ArkX-Lab/TPS65217_Test/HW/Rev_A/JLCPCB/BOM_250725.xlsx

Comment | Description | Designator | Quantity | LCSC Part #
22uF/25V/2012 | Ceramic CAP_22uF/25V/2012 | C300 | 1 | C45783
100nF/50V/1608/NC | Ceramic CAP_100nF/50V/1608 | C301 | 1
100nF/50V/1608 | Ceramic CAP_100nF/50V/1608 | C302, C303, C306, C310, C311, C315, C400, C401, C405, C500 | 10 | C14663
10uF/25V/1608 | Ceramic CAP_10uF/25V/1608 | C304, C313, C316, C317, C318, C319, C320, C321, C322, C323, C324, C325, C328, C329 | 14 | C96446
2.2uF/16V/1608 | Ceramic CAP_2.2uF/16V/1608 | C305, C309, C326, C327 | 4 | C23630
470pF/50V/1608 | Ceramic CAP_470pF/50V/1608 | C307 | 1 | C1620
10uF/10V/1608 | Ceramic CAP_10uF/10V/1608 | C308, C312 | 2 | C19702
1uF/50V/1608 | Ceramic CAP_1uF/50V/1608 | C314 | 1 | C15849
4.7uF/16V/1608 | Ceramic CAP_4.7uF/16V/1608 | C402 | 1 | C19666
100nF/16V/1005 | Ceramic CAP_100nF/16V/1005 | C403 | 1 | C1525
15pF/16V/1608/NC | Ceramic CAP_15pF/16V/1608 | C404 | 1
0R/3216 | RES_0R/3216/0.25W | R300, R301 | 2 | C17888
10K/1608/NC | RES_10K/1608/0.1W | R302, R303 | 2
100K/1608 | RES_100K/1608/0.1W | R304, R305, R323, R400, R401 | 5 | C25803
680R/2012 | RES_680R/2012/0.125W | R306, R500 | 2 | C17798
0R/2012 | RES_0R/2012/0.125W | R307, R308, R309, R310, R311, R313, R315 | 7 | C17477
200K/1608 | RES_200K/1608/0.1W | R312 | 1 | C25811
510R/1608 | RES_510R/1608/0.1W | R314, R328, R329, R402, R403, R404, R405 | 7 | C23193
330K/1608 | RES_330K/1608/0.1W | R316 | 1 | C23137
1.5K/2012 | RES_1.5K/2012/0.125W | R317, R318 | 2 | C4310
0R/1608 | RES_0R/1608/0.1W | R319, R320, R321, R322, R324, R325, R326, R327 | 8 | C21189
1M/1608 | RES_1M/1608/0.1W | R501 | 1 | C22935
TPS65217DRSLR | Battery Management, Display (LED Drivers), Handheld/Mobile Devices, Power Supply PMIC 48-VQFN (6x6) | U300 | 1 | C702315
MIC5209YM-TR | Linear Voltage Regulator IC Positive Adjustable 1 Output 500mA 8-SOIC | U301 | 1 | C461593
AMS1117-3.3 | 72dB@(120Hz) 1A 1.3V@(800mA) Fixed 3.3V~3.3V Positive 1 SOT-223 Linear Voltage Regulators (LDO) ROHS | U302 | 1 | C6186
STM32C011F6U6TR | ARM® Cortex®-M0+ STM32C0 Microcontroller IC 32-Bit 48MHz 32KB (32K x 8) FLASH 20-UFQFPN (3x3) | U400 | 1 | C5456206
SX1M48.000M10F30TNN(48MHz) | 1.62V~3.63V ±10ppm CMOS 48MHz SMD2016-4P Oscillators ROHS | X400 | 1 | C2901617
LQM2HPN2R2MG0L | 2.2 µH Shielded Multilayer Inductor 1.3 A 100mOhm Max 1008 (2520 Metric) | L300, L301, L302 | 3 | C86092
GREEN/2012 | Colorless transparence -30℃~+85℃ Positive post Common anode RGB 120° 0805 Light Emitting Diodes (LED) ROHS | LED300, LED301, LED302, LED303, LED500 | 5 | C2962094
BLUE/2012 | Colorless transparence -30℃~+85℃ Positive post Common anode RGB 120° 0805 Light Emitting Diodes (LED) ROHS | LED400, LED401, LED402, LED403 | 4 | C2962094
MC-311S | USB 2.0 5A 1 Surface Mount 16 Female -35℃~+75℃ Type-C SMD USB Connectors ROHS | CN501 | 1 | C2977718
K2-1102SP-C4SC-04 | -25℃~+85℃ 6mm 5mm Round Button 50mA Brick nogging 6mm SPST 100MΩ 100000 250gf@±30gf 12V SMD Tactile Switches ROHS | SW300, SW301, SW401 | 3 | C127509
