ArkX-Lab/TPS65217_Test/HW/Rev_A/TPS65217_Test_Bd/TPS65217_Test_Bd.pdf

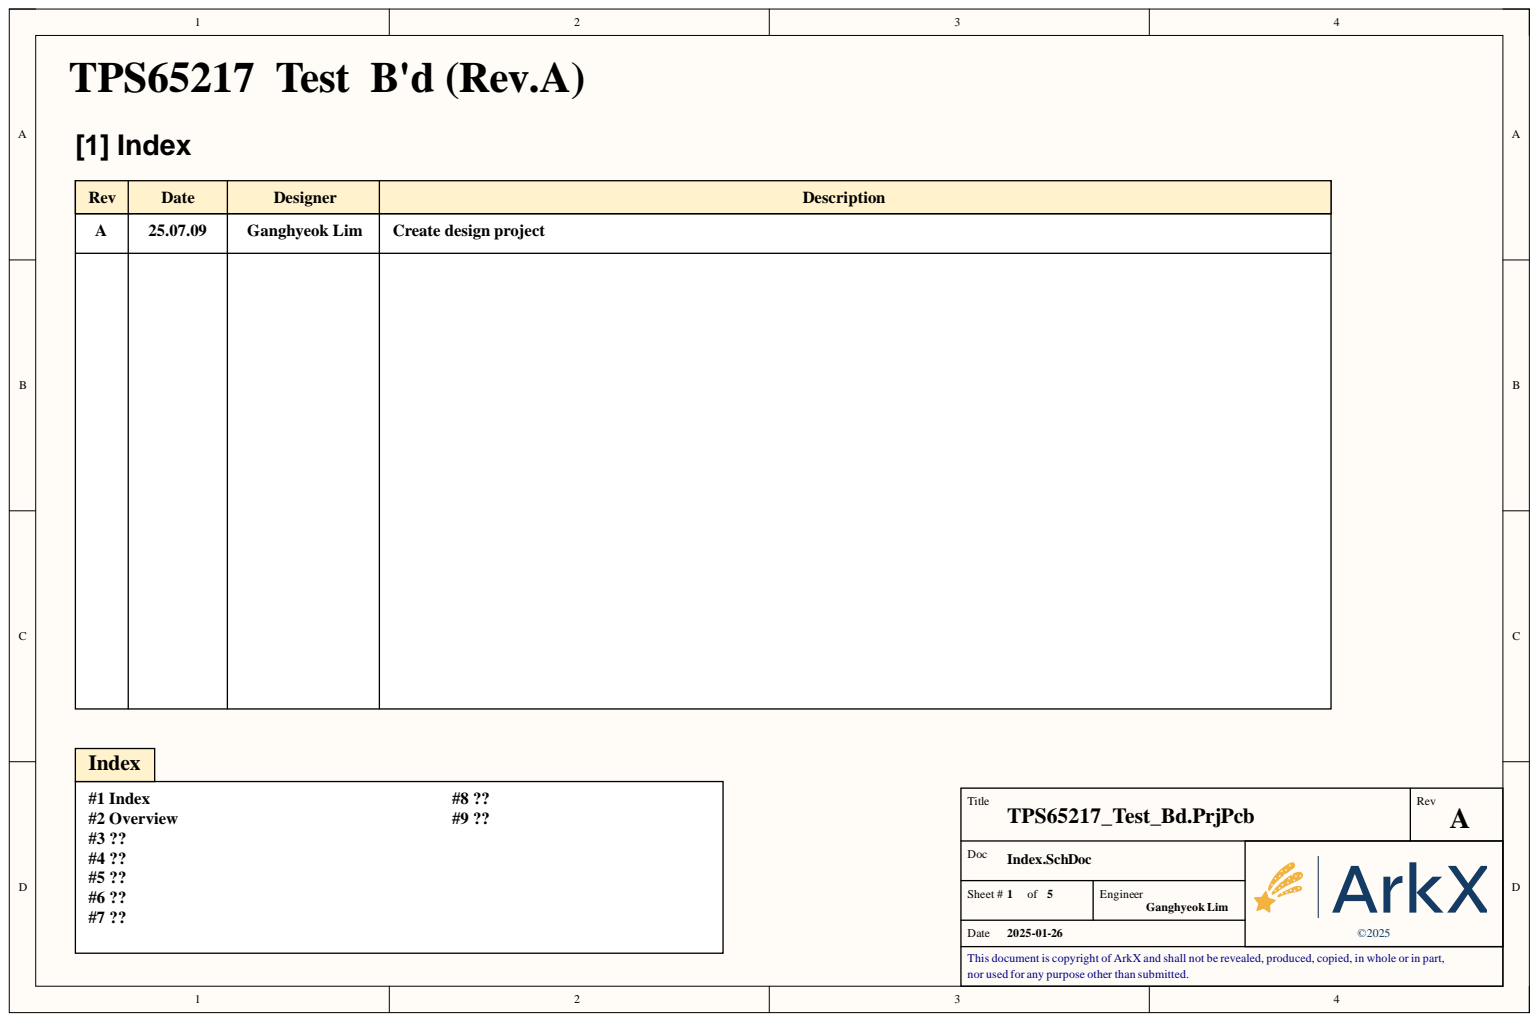
[picture p1: page 1]

Rev | Date | Designer | Description

A | 25.07.09 | Ganghyeok Lim | Create design project

Title TPS65217_Test_Bd.PrjPcb | Rev A

Doc Index.SchDoc | ©2025

Sheet # 1 of 5 | Engineer Ganghyeok Lim

This document is copyright of ArkX and shall not be revealed, produced, copied, in whole or in part,
nor used for any purpose other than submitted.

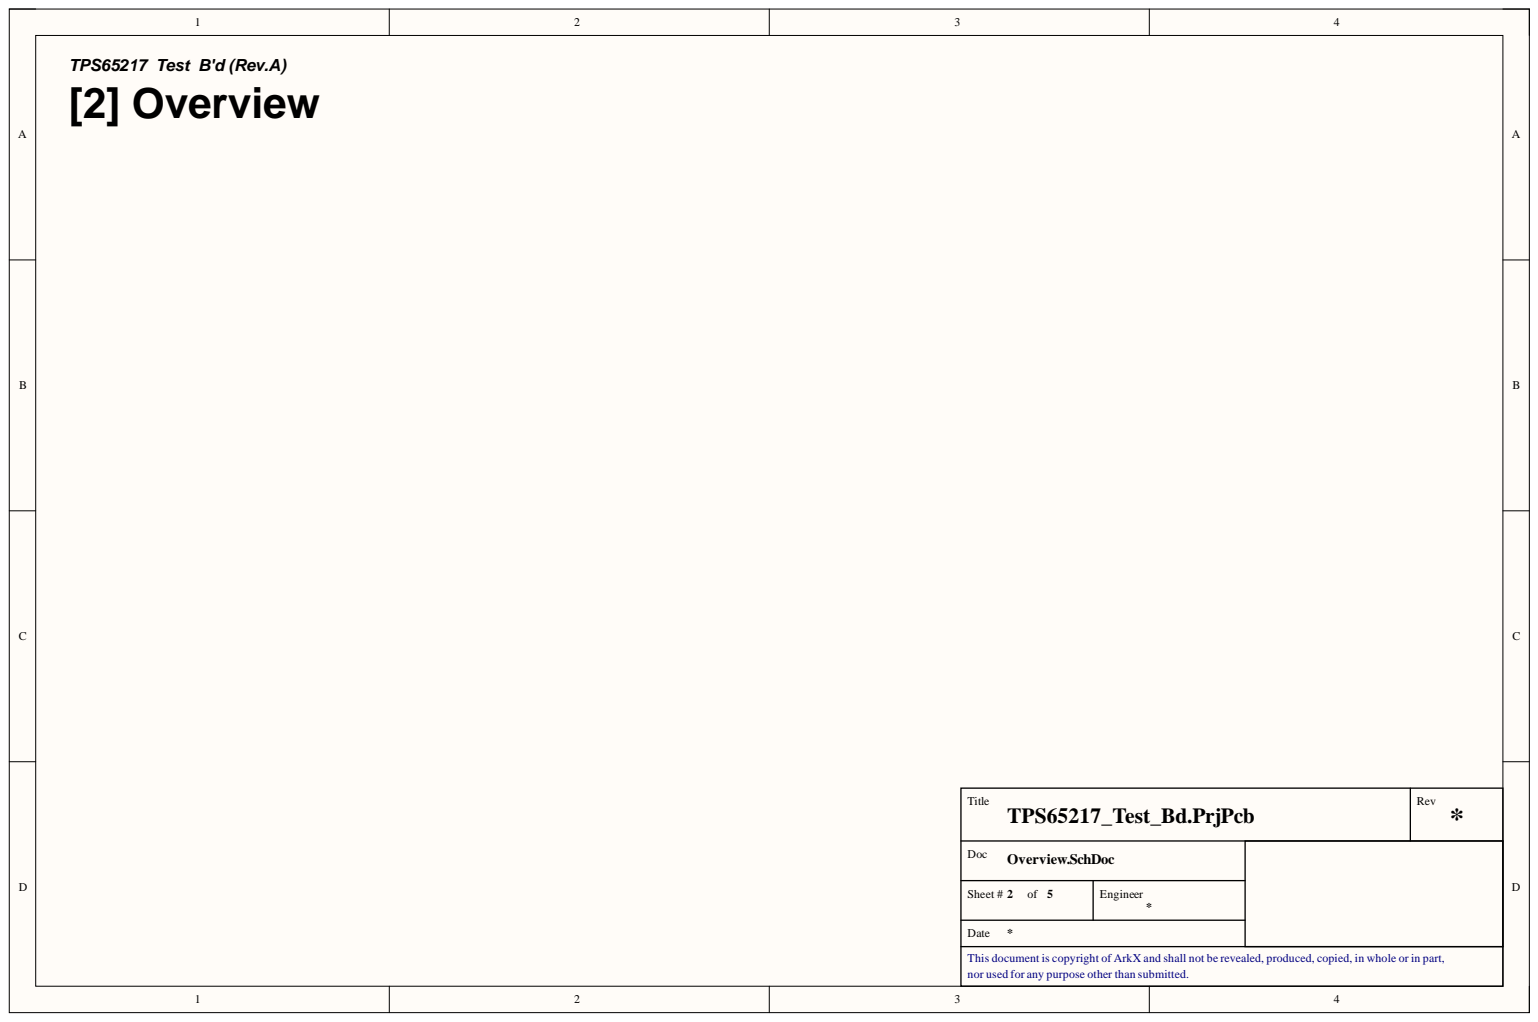
[picture p2: page 2]

Title TPS65217_Test_Bd.PrjPcb | Rev *

Doc Overview.SchDoc

Sheet # 2 of 5 | Engineer *

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

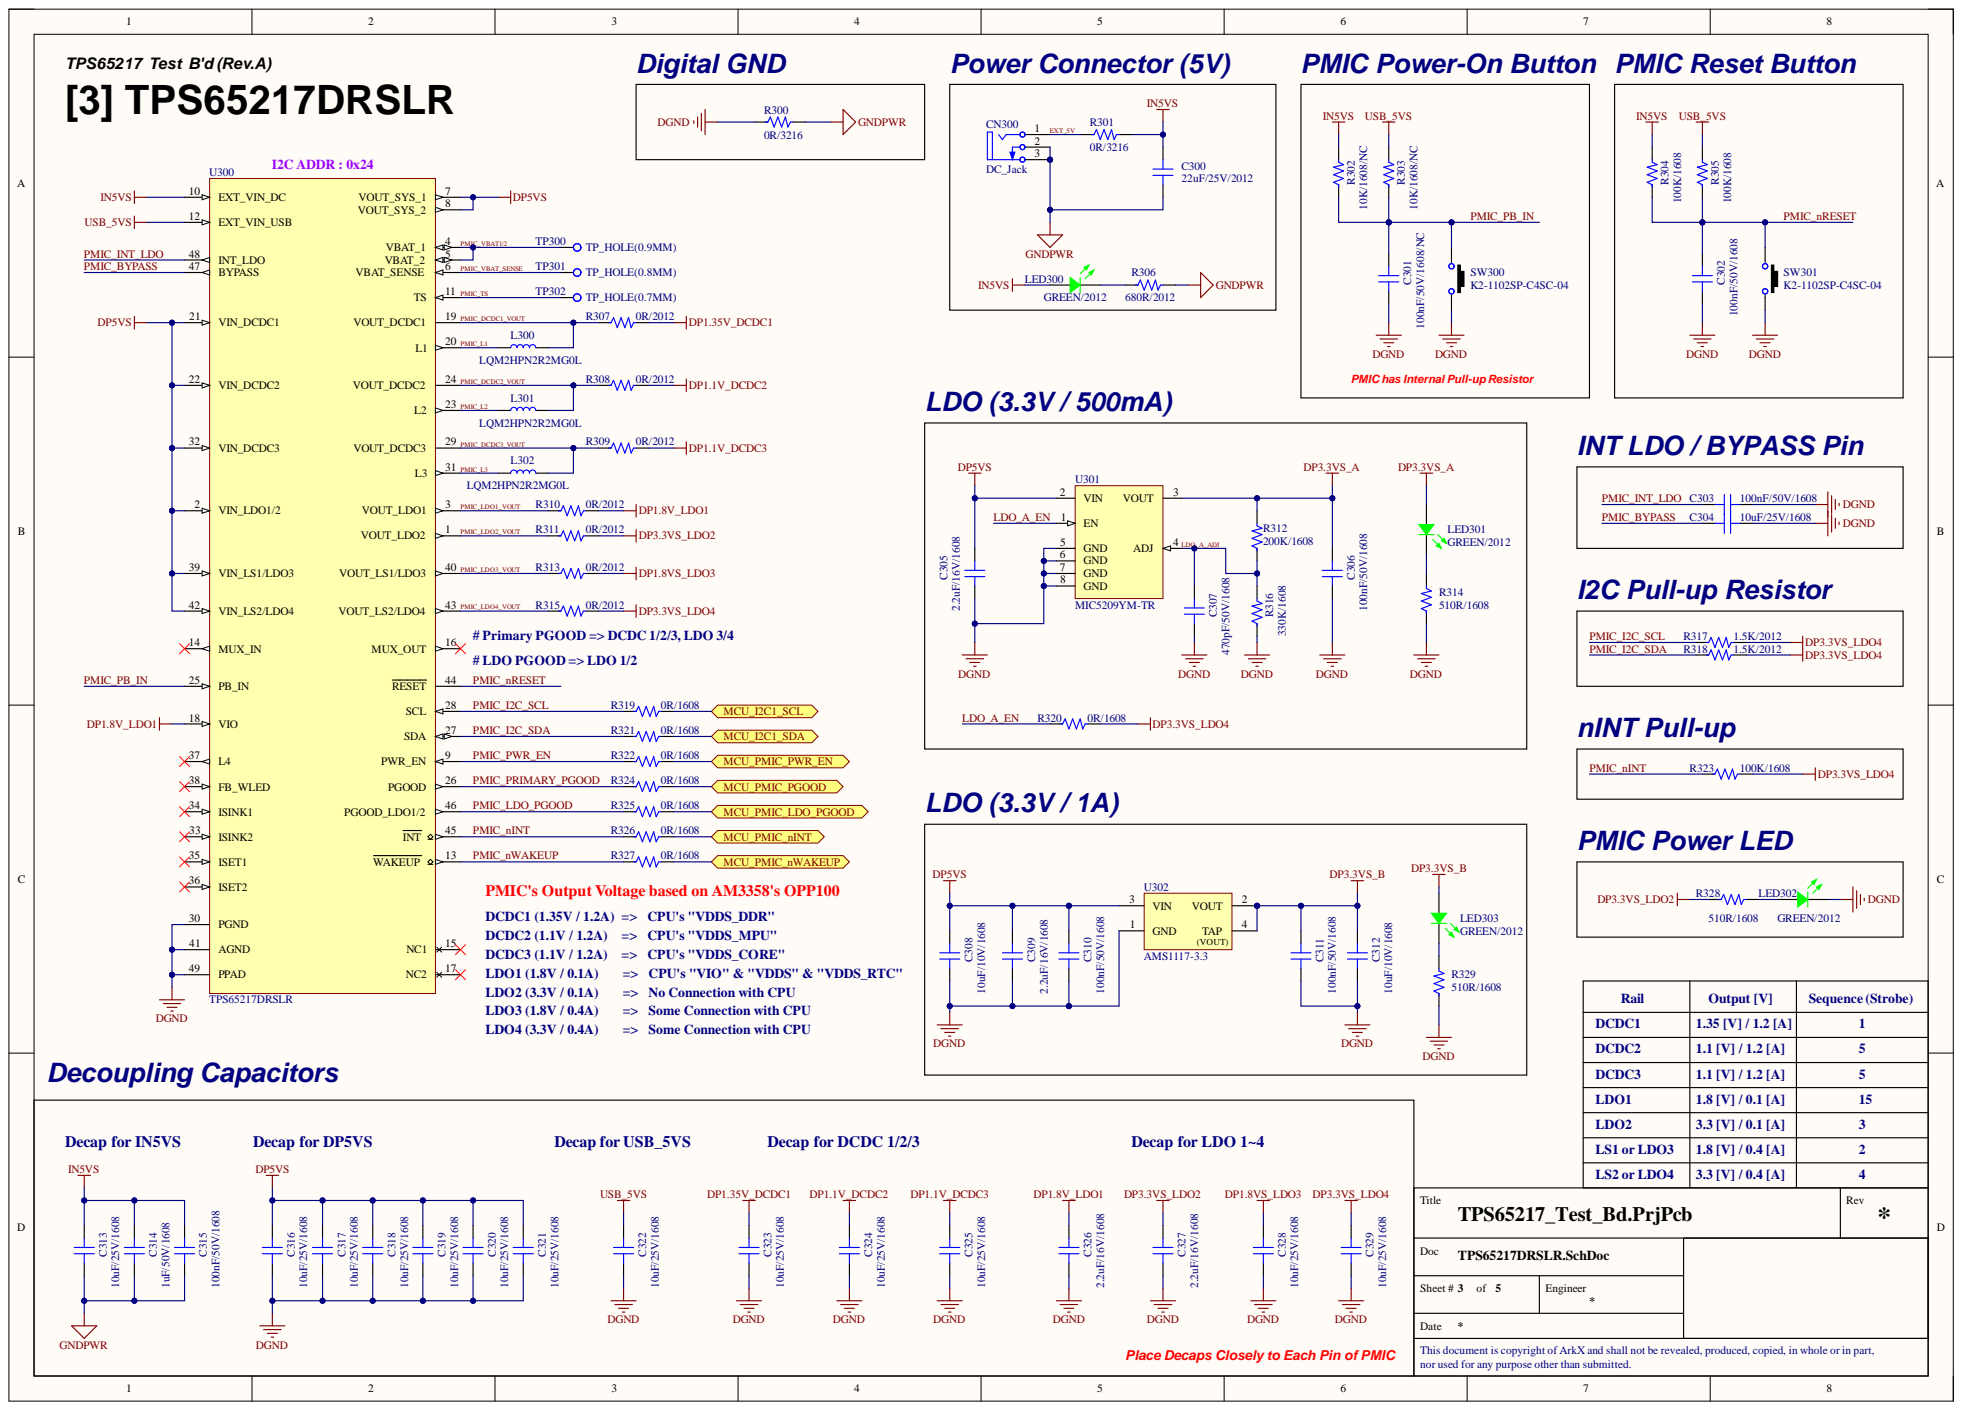
[picture p3: page 3]

PMIC Power-On Button

VIN_DCDC2 22

PMIC has Internal Pull-up Resistor

VIN_DCDC3 32

INT LDO / BYPASS Pin

# Primary PGOOD => DCDC 1/2/3, LDO 3/4

GND 1

AGND 41

PPAD 49

Rail | Output [V] | Sequence (Strobe)

DCDC1 | 1.35 [V] / 1.2 [A] | 1

DCDC3 | 1.1 [V] / 1.2 [A] | 5

LDO1 | 1.8 [V] / 0.1 [A] | 15

LDO2 | 3.3 [V] / 0.1 [A] | 3

LS1 or LDO3 | 1.8 [V] / 0.4 [A] | 2

LS2 or LDO4 | 3.3 [V] / 0.4 [A] | 4

Title TPS65217_Test_Bd.PrjPcb | Rev *

Doc TPS65217DRSLR.SchDoc

Sheet # 3 of 5 | Engineer *

Place Decaps Closely to Each Pin of PMIC

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

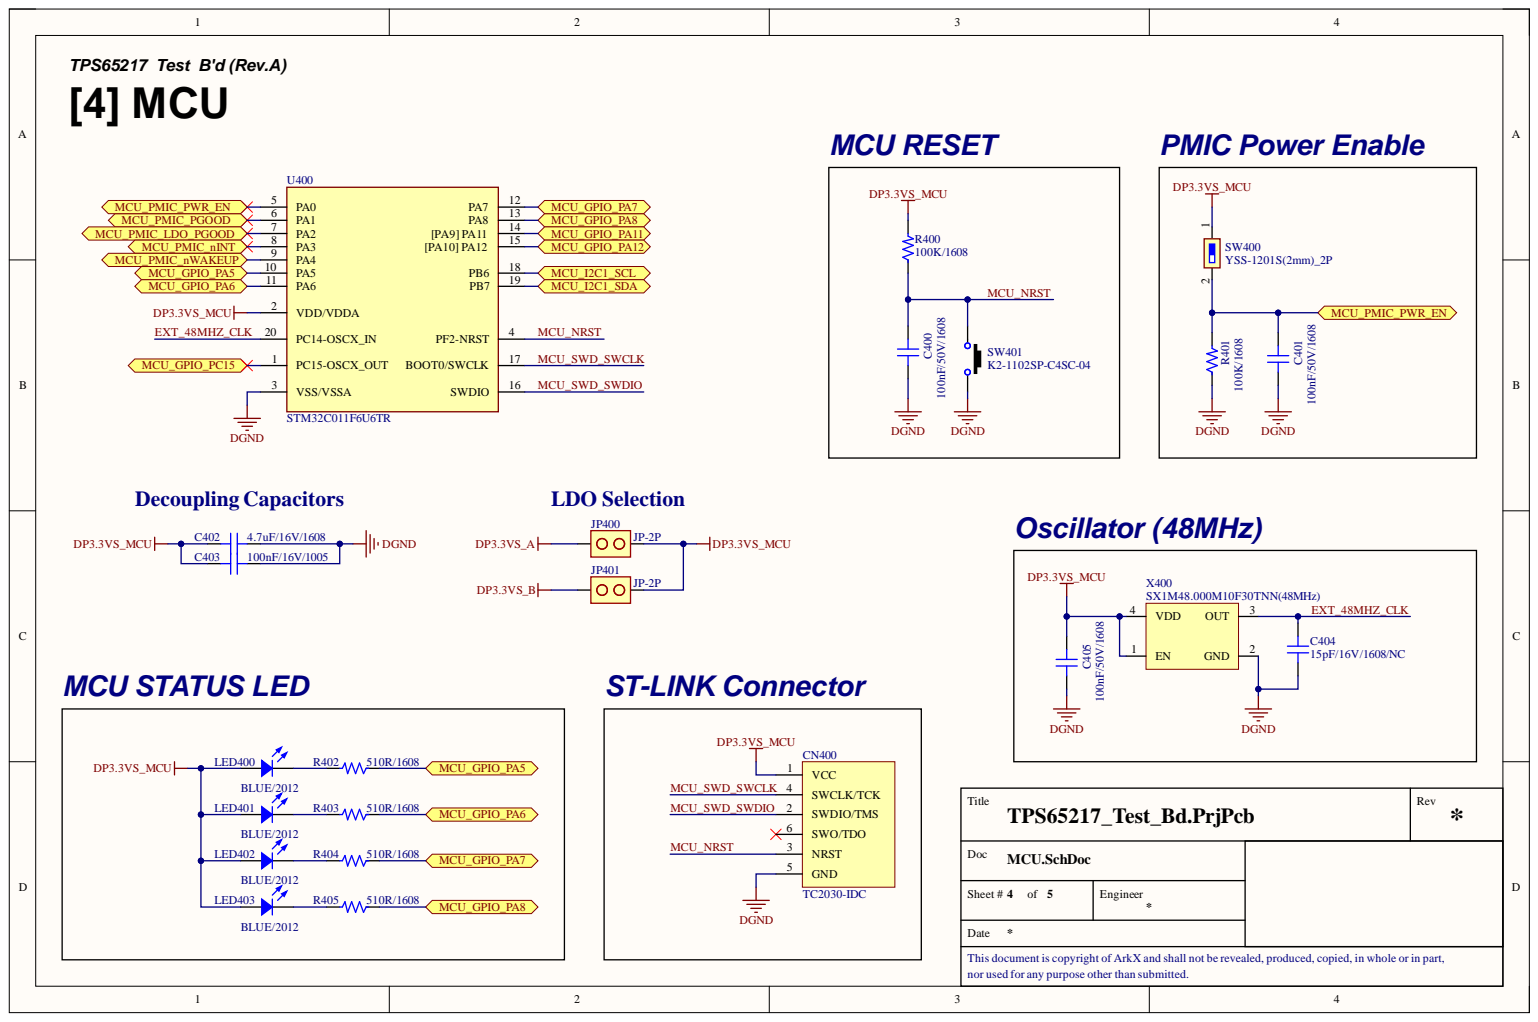
[picture p4: page 4]

Title TPS65217_Test_Bd.PrjPcb | Rev *

Doc MCU.SchDoc

Sheet # 4 of 5 | Engineer *

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

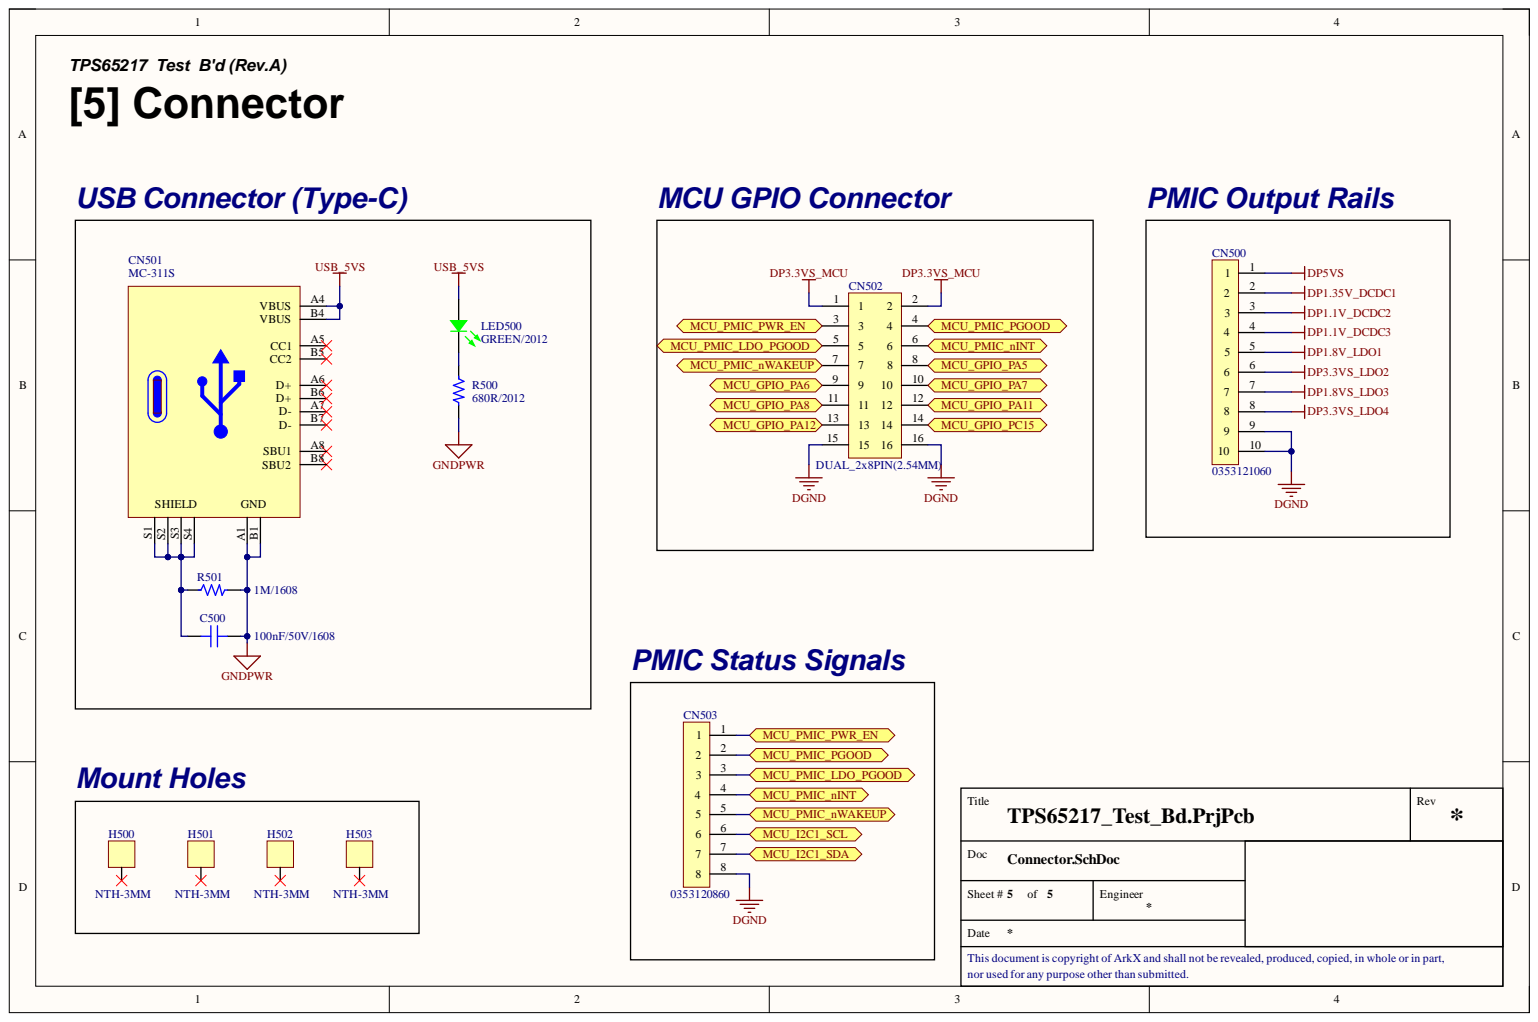
[picture p5: page 5]

Title TPS65217_Test_Bd.PrjPcb | Rev *

Doc Connector.SchDoc

Sheet # 5 of 5 | Engineer *

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

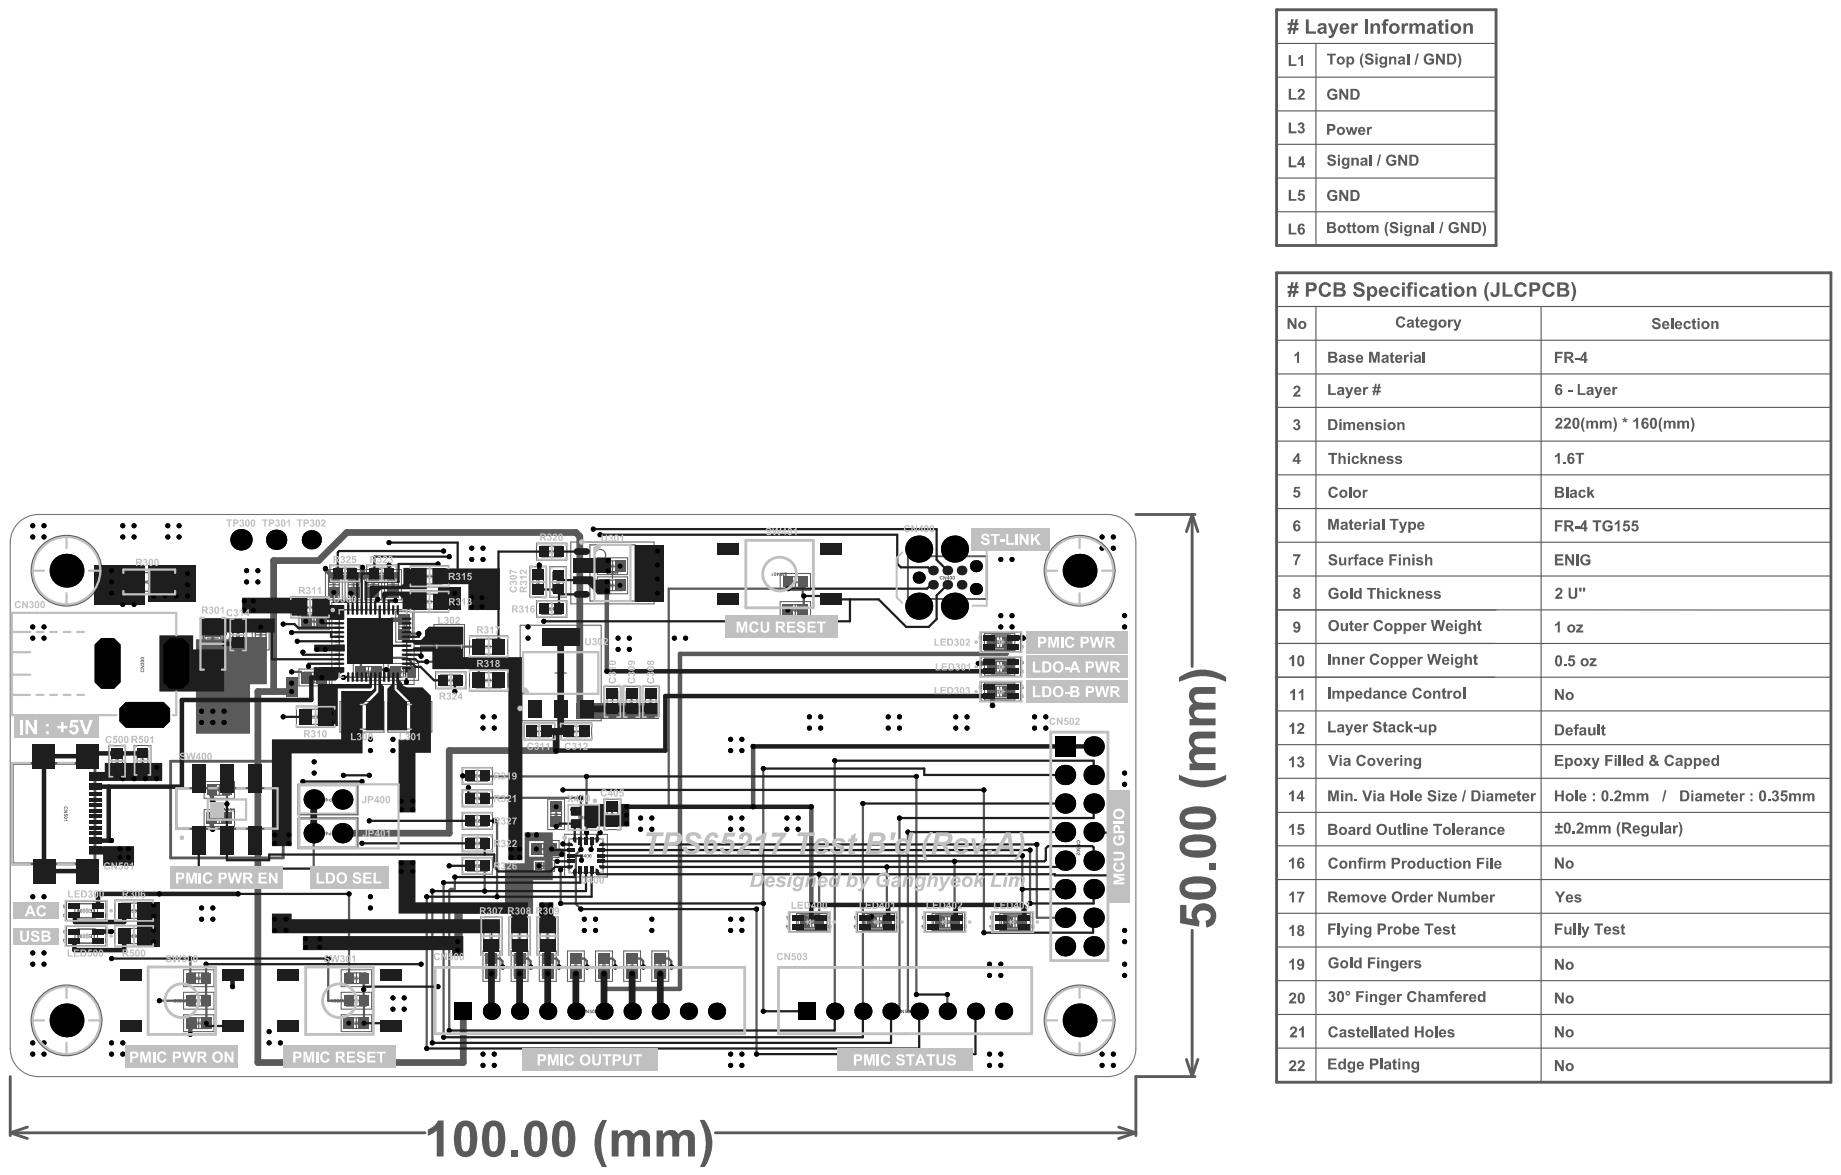
[picture p6: page 6]
