ArkX-Lab/TPS65217_Test/(list of files, drawings)

Other design files:
HW/Rev_A/TPS65217_Test_Bd/Connector.SchDoc
HW/Rev_A/TPS65217_Test_Bd/Index.SchDoc
HW/Rev_A/TPS65217_Test_Bd/MCU.SchDoc
HW/Rev_A/TPS65217_Test_Bd/Overview.SchDoc
HW/Rev_A/TPS65217_Test_Bd/TPS65217_Test_Bd.PrjPcb
HW/Rev_A/TPS65217_Test_Bd/TPS65217DRSLR.SchDoc
