ArkX-Lab/TPS65217_Test/FW/STM32_Project/CubeMX/Core/Src/main.c

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
/* Includes ------------------------------------------------------------------*/
#include "main.h"

/* USER CODE BEGIN PD */
#define MCU_GPIO_PA_X_Pin		MCU_GPIO_PA5_Pin
#define I2C1_SLAVE_ADDR 		(0x24 << 1)
#define REG_ADDR_CHIP_ID		(0x00)
#define REG_ADDR_INT			(0x02)
#define REG_ADDR_PASSWD			(0x0B)
#define REG_ADDR_ENABLE			(0x16)
#define REG_ADDR_SEQ6			(0x1E)
/* USER CODE END PD */


I2C_HandleTypeDef hi2c1;

/* USER CODE BEGIN PV */
uint8_t tx_buffer = 0;
uint8_t rx_buffer = 0;
uint8_t	chip_id = 0;
uint8_t int_status = 0;
uint8_t reg_enable = 0;
uint8_t reg_seq6 = 0;

uint8_t reg_passwd = 0;
/* USER CODE END PV */

void SystemClock_Config(void);
static void MX_GPIO_Init(void);
static void MX_I2C1_Init(void);
/**
  * @brief  The application entry point.
  * @retval int
  */
int main(void)
{

  /* MCU Configuration--------------------------------------------------------*/

  /* Reset of all peripherals, Initializes the Flash interface and the Systick. */
  HAL_Init();

  /* Configure the system clock */
  SystemClock_Config();

  /* Initialize all configured peripherals */
  MX_GPIO_Init();
  MX_I2C1_Init();
  /* USER CODE BEGIN 2 */

  // Wait for TPS65217's Power-Up Sequence
  HAL_Delay(3000);

  /* USER CODE END 2 */

  /* Infinite loop */
  /* USER CODE BEGIN WHILE */
  while (1)
  {
    /* USER CODE END WHILE */

    /* USER CODE BEGIN 3 */
  
    // 1. Read Chip ID
    HAL_I2C_Mem_Read(&hi2c1, I2C1_SLAVE_ADDR, REG_ADDR_CHIP_ID, 1, &rx_buffer, 1, HAL_MAX_DELAY);
    chip_id = rx_buffer;
	  HAL_Delay(100);


    // 2. Read Enable Register
    HAL_I2C_Mem_Read(&hi2c1, I2C1_SLAVE_ADDR, REG_ADDR_ENABLE, 1, &rx_buffer, 1, HAL_MAX_DELAY);
    reg_enable = rx_buffer;
	  HAL_Delay(100);


    // 3. Disable Rail : LDO1
    // 3-1. Write Password Register
    reg_passwd = REG_ADDR_ENABLE ^ 0x7D;
    tx_buffer = reg_passwd;
    HAL_I2C_Mem_Write(&hi2c1, I2C1_SLAVE_ADDR, REG_ADDR_PASSWD, 1, &tx_buffer, 1, HAL_MAX_DELAY);
    HAL_Delay(50);

    // 3-2. Write Enable Register
    tx_buffer = reg_enable & ~((0x1 << 1) | (0x1 << 4));
    HAL_I2C_Mem_Write(&hi2c1, I2C1_SLAVE_ADDR, REG_ADDR_ENABLE, 1, &tx_buffer, 1, HAL_MAX_DELAY);
    HAL_Delay(50);

    // Wait 1[sec]
    HAL_Delay(1000);

    // 5. Enable Rail : LDO1
    // 5-1. Write Password Register
    reg_passwd = REG_ADDR_ENABLE ^ 0x7D;
    tx_buffer = reg_passwd;
    HAL_I2C_Mem_Write(&hi2c1, I2C1_SLAVE_ADDR, REG_ADDR_PASSWD, 1, &tx_buffer, 1, HAL_MAX_DELAY);
    HAL_Delay(50);

    // 5-2. Write Enable Register
    tx_buffer = reg_enable | ((0x1 << 1) | (0x1 << 4));
    HAL_I2C_Mem_Write(&hi2c1, I2C1_SLAVE_ADDR, REG_ADDR_ENABLE, 1, &tx_buffer, 1, HAL_MAX_DELAY);
    HAL_Delay(50);

    // Wait 1[sec]
    HAL_Delay(1000);
  }
  /* USER CODE END 3 */
}

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
