ArkX-Lab/TPS65217_Test/(commit log)

2025-07-10 [Add] Altium Project (Index ~ Connector Pages)
    Complete Schematic Design of TPS65217 Test B'd
    [Connector.SchDoc, Index.SchDoc, MCU.SchDoc, Overview.SchDoc, TPS65217DRSLR.SchDoc, TPS65217_Test_Bd.PrjPcb]
2025-07-12 [Add] PCB Part Placement
    Part Placement of PCB is done
    [Connector.SchDoc, MCU.SchDoc, TPS65217DRSLR.SchDoc, TPS65217_Test_Bd.PrjPcb]
2025-07-18 [Add] Block Diagram of Board
    - Added File : TPS65217_Test_Bd_Block_Diagram (.pptx)
2025-07-22 [Done] PCB Part Placement
    [TPS65217_Test_Bd.PrjPcb]
2025-07-24 [Done] PCB Routing (DRC Completed)
    [TPS65217_Test_Bd.PrjPcb]
2025-07-24 [Done] Generate Fab Files for PCBA Order
    Fab Files are generated and PCBA Order is completed
    [BOM_250725.xlsx, TPS65217_Test_Bd.PrjPcb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]
2025-08-24 [Fix] FW code for TPS65217's Register Read & Write
    [CubeMX.ioc, main.c, main.h]
