ArkX-Lab/TPS65217_Test/(notices)

Notices in the files:
FW/STM32_Project/CubeMX/Core/Src/main.c:
Copyright (c) 2025 STMicroelectronics.
All rights reserved.
This software is licensed under terms that can be found in the LICENSE file
